dragonplus-electronics/Dragon-Beta/LINKS.md

# Useful Links

## Prime6809's GitHub

https://github.com/prime6809

https://github.com/prime6809/DragonBetaOS  - Dragon Beta OS ROMs

https://github.com/prime6809/PS2Keyboard_to_Matrix  - PS/2 keyboard adapter

## Dragon Data Archive

http://dragondata.co.uk/  - won't work on Chrome for me  - needs MS Edge

http://dragondata.co.uk/tech/circuit-diag/beta/index.html  - some original partial Dragon Beta schematics

http://dragondata.co.uk/tech/specs/ext-OS-9-Dragon-128.html  - Vivaway extensions for OS9 to support Beta

## World of Dragon

https://archive.worldofdragon.org/index.php?title=Main_Page

https://archive.worldofdragon.org/phpBB3/  - WoD forums

https://archive.worldofdragon.org/index.php?title=Project_Beta  - Dragon Beta Description and Pictures

http://archive.worldofdragon.org/archive/index.php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  - Original software disk images

https://archive.worldofdragon.org/index.php?title=Motherboard_Pictures#Dragon_Beta  - Motherboard Images

## Facebook Group

https://www.facebook.com/groups/dragon32
